POACH3/Recoil-Measurement/media/board_layout.png

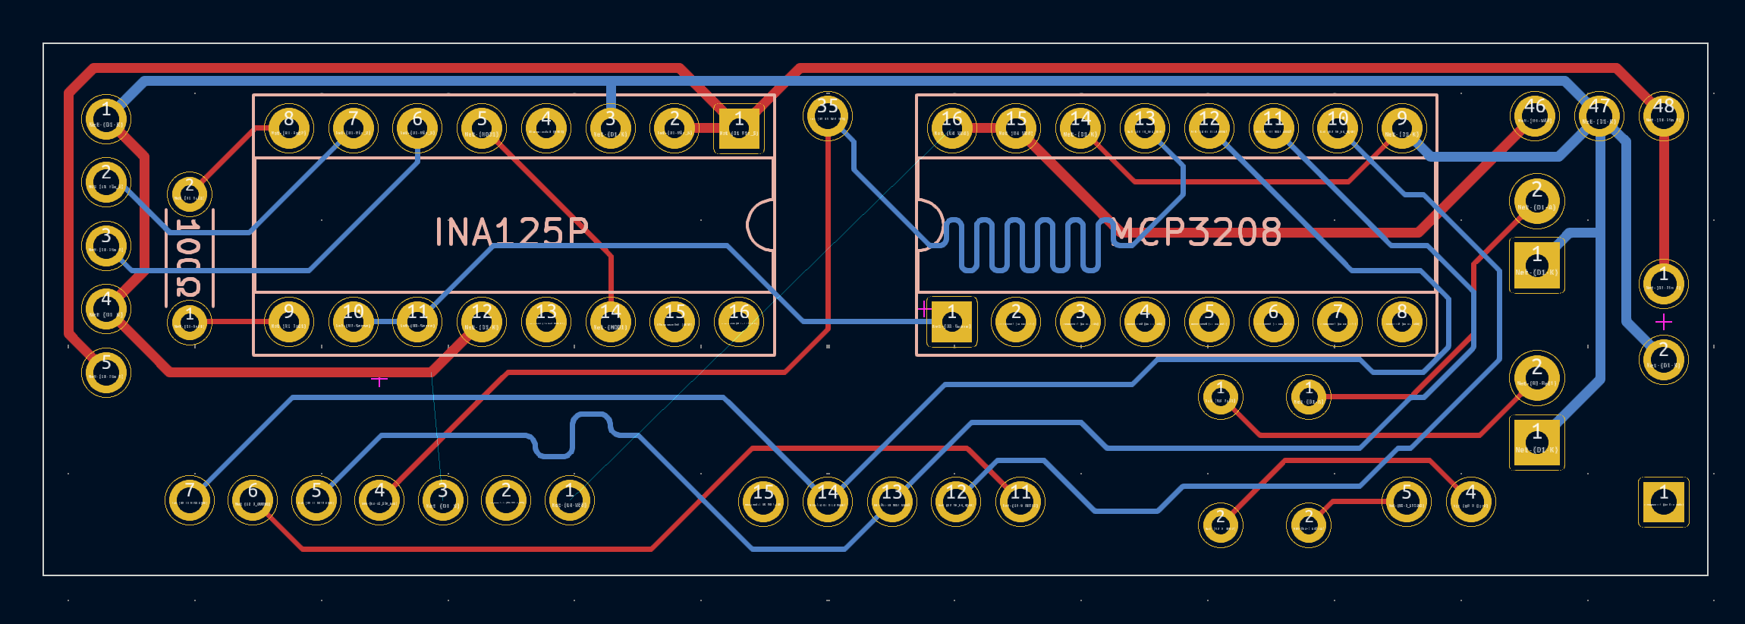
media/board_layout.png
