POACH3/Recoil-Measurement/media/circuit_diagram.png

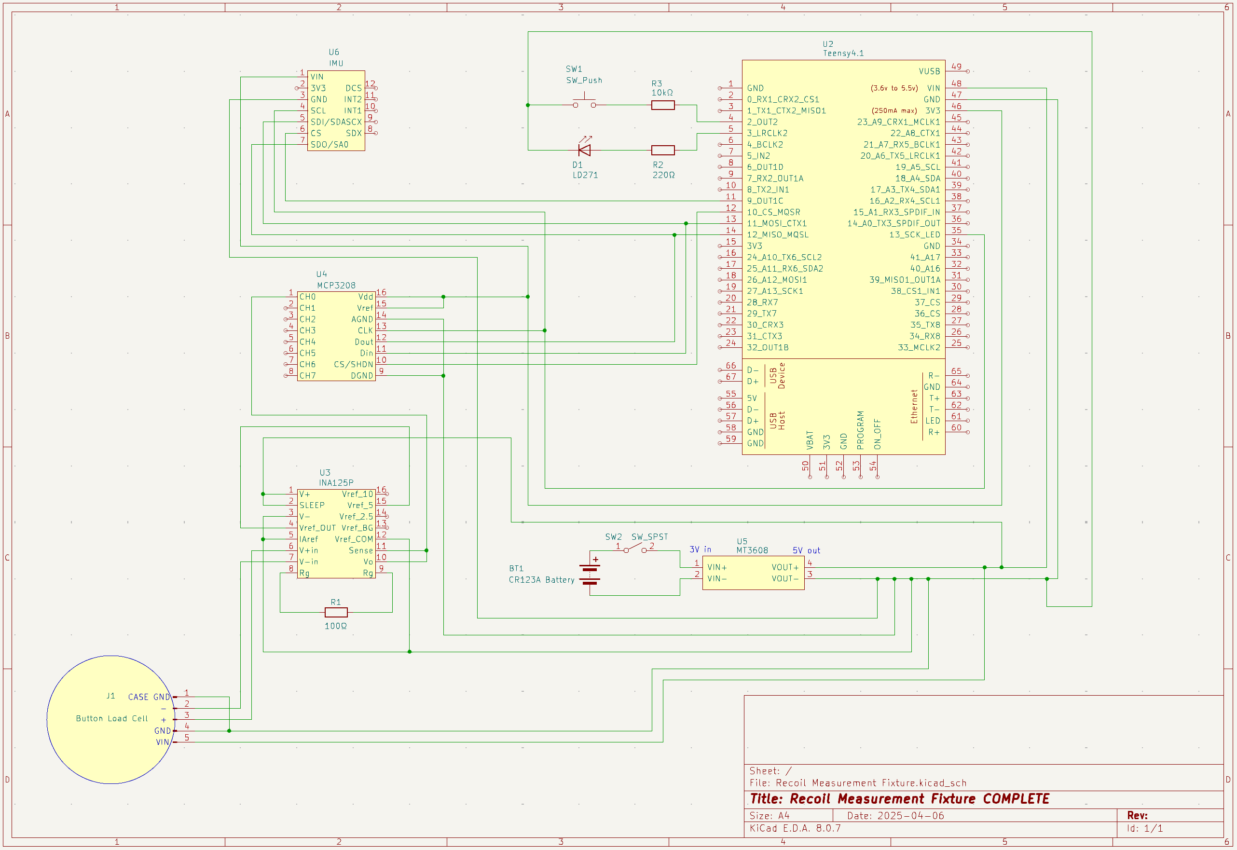
media/circuit_diagram.png
