POACH3/Recoil-Measurement/media/circuit_sketch.png

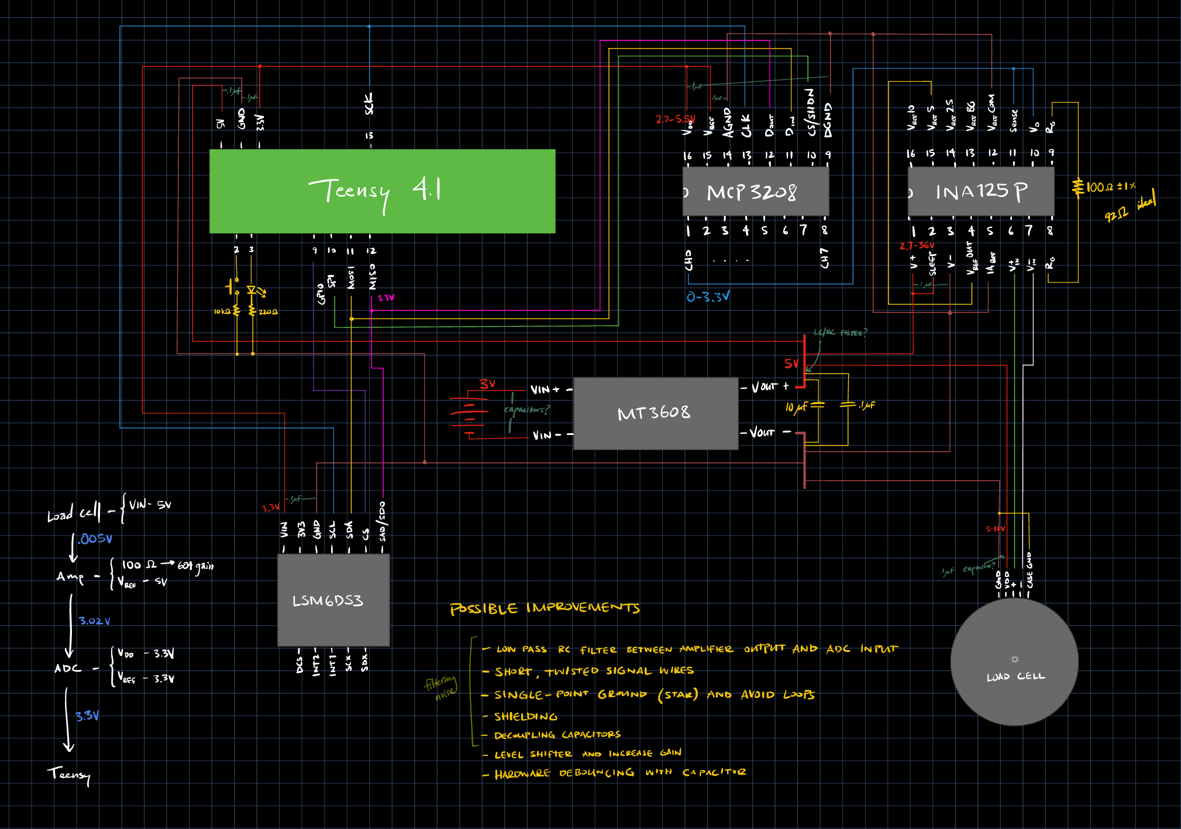
media/circuit_sketch.png
