POACH3/Recoil-Measurement/(commit log)

2024-12-24 Add button and status LED
2024-12-25 Connect button/LED to logging functionality
2024-12-27 Add data collection and logging from an IMU
2024-12-28 Integrate IMU acceleration values
2024-12-29 Add circuit diagram
2025-04-06 Add PCB file
2025-08-06 Update circuit sketch
2025-08-07 Add image of custom PCB layout
2025-08-07 Add images of prototype
