POACH3/Recoil-Measurement/(notices)

Notices in the files:
README.md:
License: Personal Use Only
